alexanderhiam/NHD-C12832A1Z_Breakout/CHANGES.TXT

********************************************************************************
*                                 CHANGES.TXT                                  *
********************************************************************************
Modifications made by Licensee.

Rev 2:
 -Fixed component numbering on silkscreen
 -Cleaned up schematics

********************************************************************************
