alexanderhiam/NHD-C12832A1Z_Breakout/src/NHD-C12832A1Z_breakout-back.jpg

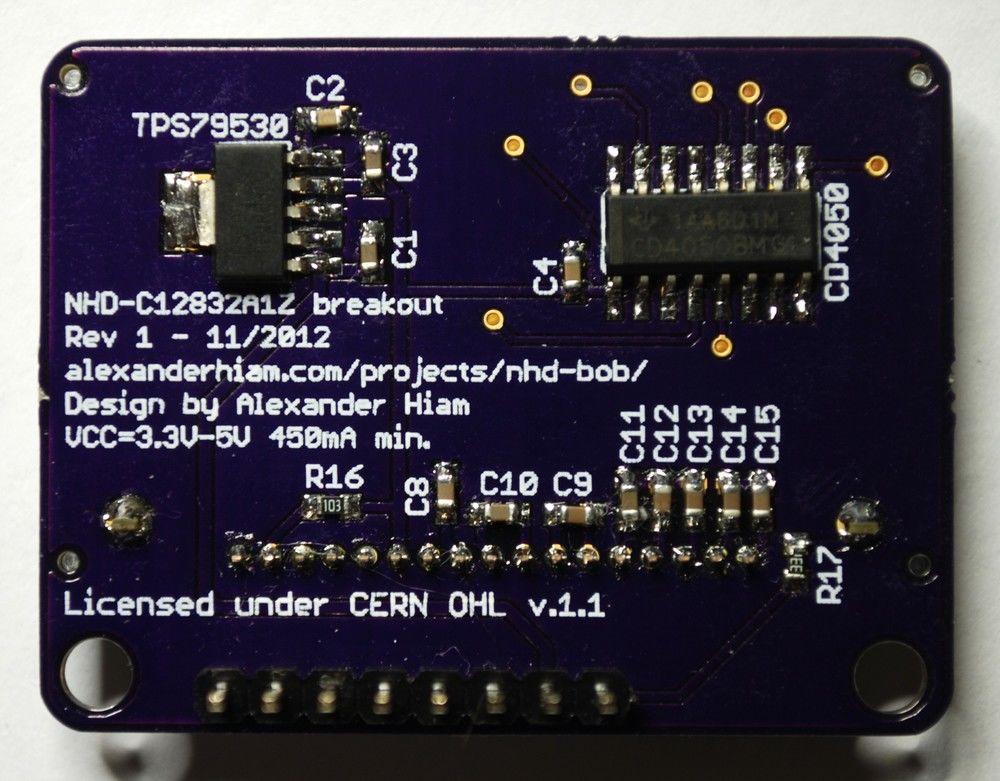
src/NHD-C12832A1Z_breakout-back.jpg
