alexanderhiam/NHD-C12832A1Z_Breakout/design_files/NHD-C12832A1Z_Breakout_rev2.brd

## EAGLE design design_files/NHD-C12832A1Z_Breakout_rev2.brd (2012-12-08)

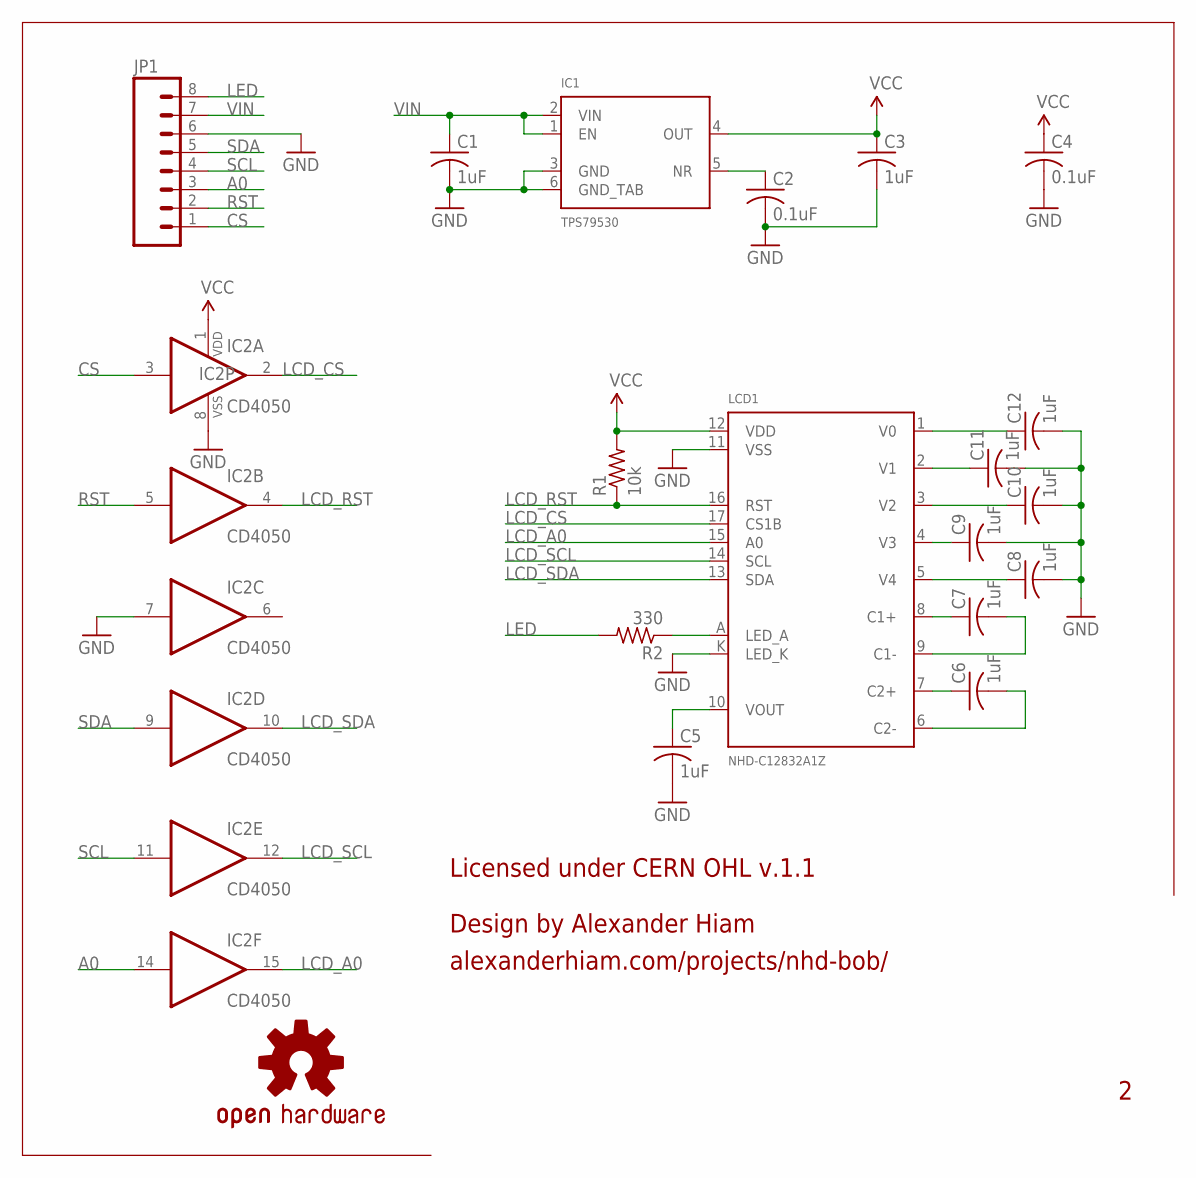
[picture p6: schematic NHD-C12832A1Z_Breakout_rev2.sch]

Parts:
C1, C3, C5, C6, C7, C8, C9, C10, C11, C12: 1uF; C0603
C2, C4: 0.1uF; C0603
IC1: TPS79530; SOT223-6
IC2: CD4050; SO16
JP1: M081X08; 1X08
LCD1: NHD-C12832A1Z
R1: 10k; R0603
R2: 330; R0603
U$1: OSHW-LOGOS; OSHW-LOGO-S
U$2: CERN_V1.1_LG

Connections:
A0: IC2.14 (I), JP1.3
CS: IC2.3 (I), JP1.1
GND: C1.2, C2.2, C3.2, C4.2, C5.2, C8.2, C9.2, C10.2, C11.2, C12.2, IC1.3 (GND), IC1.6 (GND_TAB), IC2.7 (I), IC2.8 (VSS), JP1.6, LCD1.11 (VSS), LCD1.K (LED_K)
LCD_A0: IC2.15 (O), LCD1.15 (A0)
LCD_CS: IC2.2 (O), LCD1.17 (CS1B)
LCD_RST: IC2.4 (O), LCD1.16 (RST), R1.1
LCD_SCL: IC2.12 (O), LCD1.14 (SCL)
LCD_SDA: IC2.10 (O), LCD1.13 (SDA)
LED: JP1.8, R2.2
unnamed: C2.1, IC1.5 (NR)
unnamed: LCD1.A (LED_A), R2.1
unnamed: C5.1, LCD1.10 (VOUT)
unnamed: C7.1, LCD1.8 (C1+)
unnamed: C7.2, LCD1.9 (C1-)
unnamed: C6.1, LCD1.7 (C2+)
unnamed: C6.2, LCD1.6 (C2-)
unnamed: C12.1, LCD1.1 (V0)
unnamed: C11.1, LCD1.2 (V1)
unnamed: C10.1, LCD1.3 (V2)
unnamed: C9.1, LCD1.4 (V3)
unnamed: C8.1, LCD1.5 (V4)
RST: IC2.5 (I), JP1.2
SCL: IC2.11 (I), JP1.4
SDA: IC2.9 (I), JP1.5
VCC: C3.1, C4.1, IC1.4 (OUT), IC2.1 (VDD), LCD1.12 (VDD), R1.2
VIN: C1.1, IC1.1 (EN), IC1.2 (VIN), JP1.7

Notes on the sheet:
Design by Alexander Hiam
alexanderhiam.com/projects/nhd-bob/

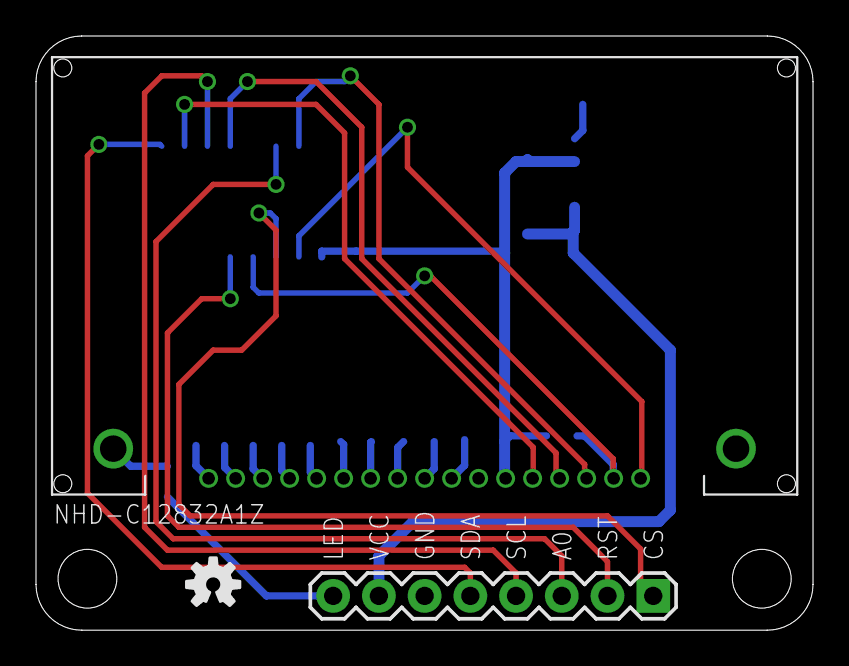
[picture p7: board NHD-C12832A1Z_Breakout_rev2.brd from above]

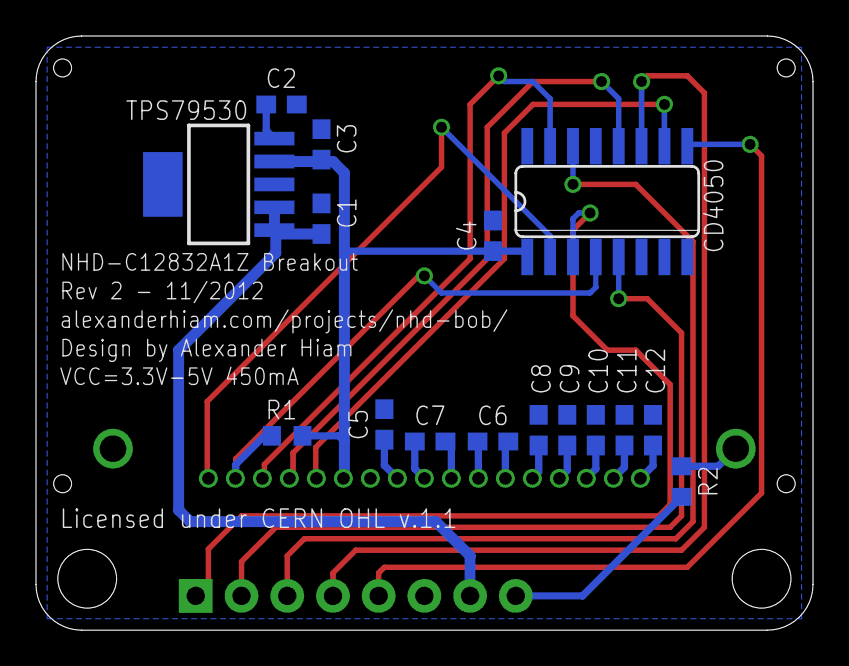
[picture p8: board NHD-C12832A1Z_Breakout_rev2.brd from below]

Board: 2 copper layers, 43.2 x 33.0 mm, 20 parts (17 on the bottom side), 26 nets.
