alexanderhiam/NHD-C12832A1Z_Breakout/(notices)

Notices in the files:
parts and their libraries:
alexanderhiam: Licensed under CERN OHL v.1.1
SparkFun-Aesthetics: Licensing: CC v3.0 Share-Alike You are welcome to use this library for commercial purposes.
